costarc/MSX_IDC_ADAPTER/Hardware Interface/MSX_FPGA_Hat.pdf

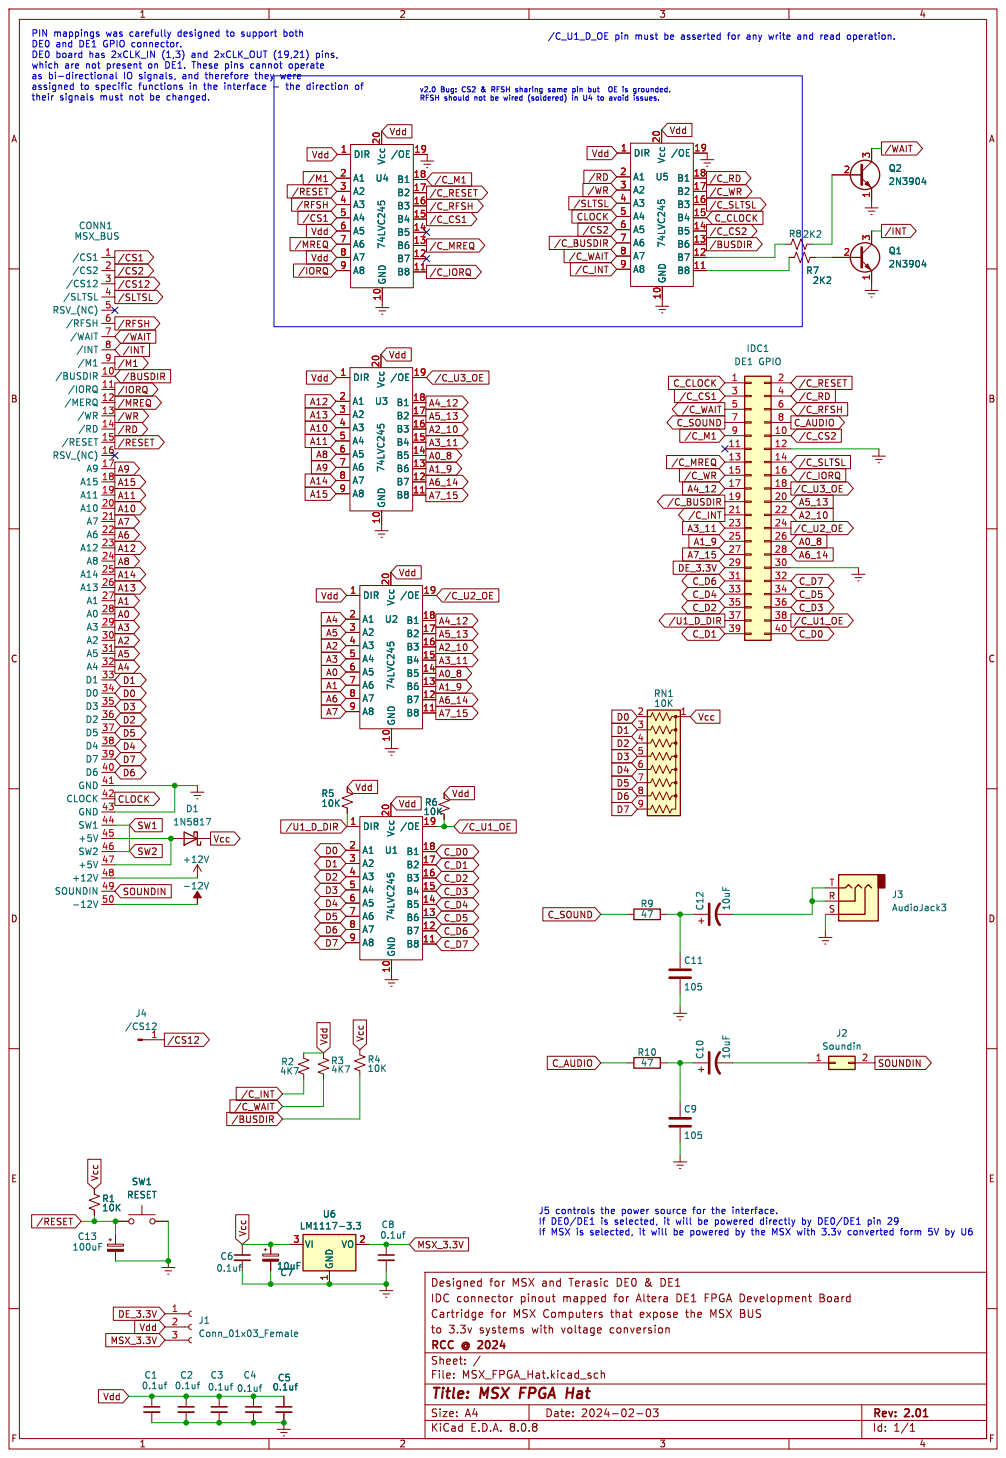
[picture p1: page 1]
