costarc/MSX_IDC_ADAPTER/Hardware Interface/MSX_FPGA_Hat.kicad_pcb

## KiCad design Hardware Interface/MSX_FPGA_Hat.kicad_pcb (2025-01-13)

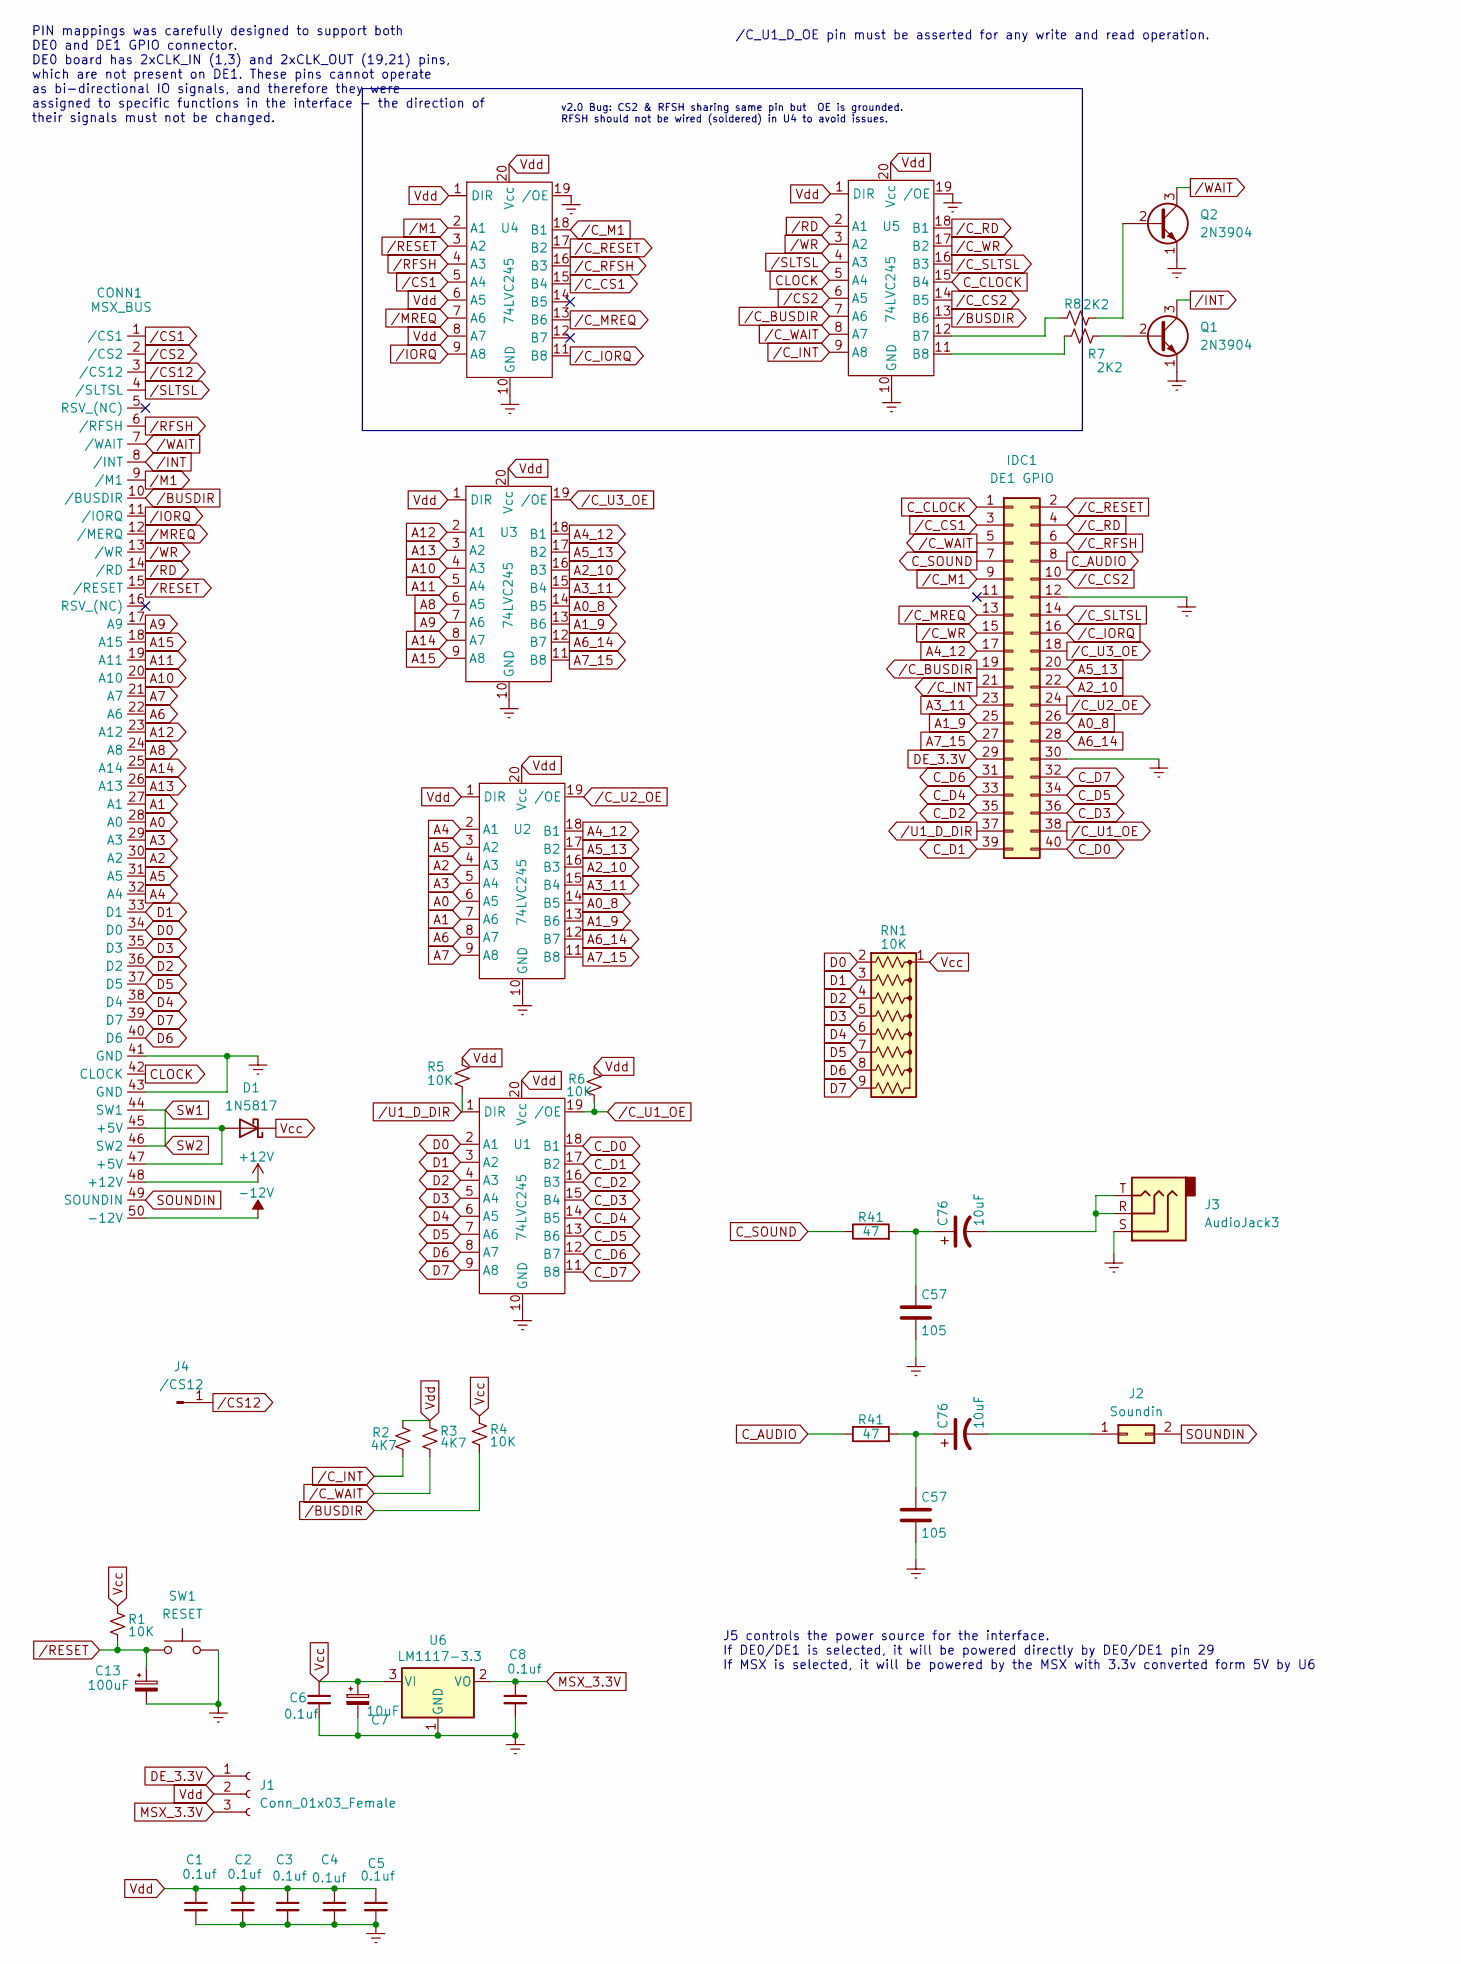
[picture p2: schematic MSX_FPGA_Hat.kicad_sch, MSX FPGA Hat]

Parts:
C1, C2, C3, C4, C5, C6, C8: 0.1uf; C_Disc_D3.0mm_W1.6mm_P2.50mm
C7, C76: 10uF; CP_Radial_D5.0mm_P2.00mm
C13: 100uF; CP_Radial_D5.0mm_P2.00mm
C57: 105; C_Disc_D5.0mm_W2.5mm_P2.50mm
CONN1: MSX_BUS; MSX_CART_SW_Official
D1: 1N5817; D_DO-41_SOD81_P10.16mm_Horizontal
IDC1: DE1 GPIO; PinHeader_2x20_P2.54mm_Vertical
J1: Conn_01x03_Female; PinHeader_1x03_P2.54mm_Vertical
J2: Soundin; PinHeader_2x01_P2.54mm_Vertical
J3: AudioJack3; Jack_3.5mm_CUI_SJ1-3533NG_Horizontal
J4: /CS12; PinHeader_1x01_P2.54mm_Vertical
Q1, Q2: 2N3904; TO-92_Inline
R1, R4, R5, R6: 10K; R_Axial_DIN0207_L6.3mm_D2.5mm_P10.16mm_Horizontal
R2, R3: 4K7; R_Axial_DIN0207_L6.3mm_D2.5mm_P10.16mm_Horizontal
R7, R8: 2K2; R_Axial_DIN0207_L6.3mm_D2.5mm_P10.16mm_Horizontal
R41: 47; R_Axial_DIN0207_L6.3mm_D2.5mm_P10.16mm_Horizontal
RN1: 10K; R_Array_SIP9
SW1: RESET; SW_Tactile_SKHH_Angled
U1, U2, U3, U4, U5: 74LVC245; DIP-20_W7.62mm
U6: LM1117-3.3; SOT-223-3_TabPin2

Connections:
+12V: CONN1.48 (+12V)
-12V: CONN1.50 (-12V)
A0: CONN1.28 (A0), U2.6 (A5)
A0_8: IDC1.26, U2.14 (B5), U3.14 (B5)
A1: CONN1.27 (A1), U2.7 (A6)
A1_9: IDC1.25, U2.13 (B6), U3.13 (B6)
A2: CONN1.30 (A2), U2.4 (A3)
A2_10: IDC1.22, U2.16 (B3), U3.16 (B3)
A3: CONN1.29 (A3), U2.5 (A4)
A3_11: IDC1.23, U2.15 (B4), U3.15 (B4)
A4: CONN1.32 (A4), U2.2 (A1)
A4_12: IDC1.17, U2.18 (B1), U3.18 (B1)
A5: CONN1.31 (A5), U2.3 (A2)
A5_13: IDC1.20, U2.17 (B2), U3.17 (B2)
A6: CONN1.22 (A6), U2.8 (A7)
A6_14: IDC1.28, U2.12 (B7), U3.12 (B7)
A7: CONN1.21 (A7), U2.9 (A8)
A7_15: IDC1.27, U2.11 (B8), U3.11 (B8)
A8: CONN1.24 (A8), U3.6 (A5)
A9: CONN1.17 (A9), U3.7 (A6)
A10: CONN1.20 (A10), U3.4 (A3)
A11: CONN1.19 (A11), U3.5 (A4)
A12: CONN1.23 (A12), U3.2 (A1)
A13: CONN1.26 (A13), U3.3 (A2)
A14: CONN1.25 (A14), U3.8 (A7)
A15: CONN1.18 (A15), U3.9 (A8)
CLOCK: CONN1.42 (CLOCK), U5.5 (A4)
C_AUDIO: IDC1.8; also elsewhere on the board
C_CLOCK: IDC1.1, U5.15 (B4)
C_D0: IDC1.40, U1.18 (B1)
C_D1: IDC1.39, U1.17 (B2)
C_D2: IDC1.35, U1.16 (B3)
C_D3: IDC1.36, U1.15 (B4)
C_D4: IDC1.33, U1.14 (B5)
C_D5: IDC1.34, U1.13 (B6)
C_D6: IDC1.31, U1.12 (B7)
C_D7: IDC1.32, U1.11 (B8)
C_SOUND: IDC1.7; also elsewhere on the board
D0: CONN1.34 (D0), RN1.2 (R1), U1.2 (A1)
D1: CONN1.33 (D1), RN1.3 (R2), U1.3 (A2)
D2: CONN1.36 (D2), RN1.4 (R3), U1.4 (A3)
D3: CONN1.35 (D3), RN1.5 (R4), U1.5 (A4)
D4: CONN1.38 (D4), RN1.6 (R5), U1.6 (A5)
D5: CONN1.37 (D5), RN1.7 (R6), U1.7 (A6)
D6: CONN1.40 (D6), RN1.8 (R7), U1.8 (A7)
D7: CONN1.39 (D7), RN1.9 (R8), U1.9 (A8)
DE_3.3V: IDC1.29, J1.1
GNDREF: C1.2, C2.2, C3.2, C4.2, C5.2, C6.2, C7.2, C8.2, C13.2, CONN1.41 (GND), CONN1.43 (GND), IDC1.12, IDC1.30, J3.S, Q1.1 (E), Q2.1 (E), SW1.2, U1.10 (GND), U2.10 (GND), U3.10 (GND), U4.10 (GND), U4.19 (/OE), U5.10 (GND), U5.19 (/OE), U6.1 (GND); also elsewhere on the board
MSX_3.3V: C8.1, J1.3, U6.2 (VO)
unnamed 51: J3.R, J3.T; also elsewhere on the board
unnamed: CONN1.45 (+5V), CONN1.47 (+5V), D1.2 (A)
unnamed 53: J2.1; also elsewhere on the board
unnamed: Q1.2 (B), R7.1
unnamed: Q2.2 (B), R8.1
unnamed: R8.2, U5.12 (B7)
unnamed: R7.2, U5.11 (B8)
SOUNDIN: CONN1.49 (SOUNDIN), J2.2
SW1: CONN1.44 (SW1), CONN1.46 (SW2)
Vcc: C6.1, C7.1, D1.1 (K), R1.1, R4.1, RN1.1 (common), U6.3 (VI)
Vdd: C1.1, C2.1, C3.1, C4.1, C5.1, J1.2, R2.1, R3.1, R5.1, R6.1, U1.20 (Vcc), U2.1 (DIR), U2.20 (Vcc), U3.1 (DIR), U3.20 (Vcc), U4.1 (DIR), U4.6 (A5), U4.8 (A7), U4.20 (Vcc), U5.1 (DIR), U5.20 (Vcc)
/BUSDIR: CONN1.10 (/BUSDIR), R4.2, U5.13 (B6)
/CS1: CONN1.1 (/CS1), U4.5 (A4)
/CS2: CONN1.2 (/CS2), U5.6 (A5)
/CS12: CONN1.3 (/CS12), J4.1
/C_BUSDIR: IDC1.19, U5.7 (A6)
/C_CS1: IDC1.3, U4.15 (B4)
/C_CS2: IDC1.10, U5.14 (B5)
/C_INT: IDC1.21, R2.2, U5.9 (A8)
/C_IORQ: IDC1.16, U4.11 (B8)
/C_M1: IDC1.9, U4.18 (B1)
/C_MREQ: IDC1.13, U4.13 (B6)
/C_RD: IDC1.4, U5.18 (B1)
/C_RESET: IDC1.2, U4.17 (B2)
/C_RFSH: IDC1.6, U4.16 (B3)
/C_SLTSL: IDC1.14, U5.16 (B3)
/C_U1_OE: IDC1.38, R6.2, U1.19 (/OE)
/C_U2_OE: IDC1.24, U2.19 (/OE)
/C_U3_OE: IDC1.18, U3.19 (/OE)
/C_WAIT: IDC1.5, R3.2, U5.8 (A7)
/C_WR: IDC1.15, U5.17 (B2)
/INT: CONN1.8 (/INT), Q1.3 (C)
/IORQ: CONN1.11 (/IORQ), U4.9 (A8)
/M1: CONN1.9 (/M1), U4.2 (A1)
/MREQ: CONN1.12 (/MERQ), U4.7 (A6)
/RD: CONN1.14 (/RD), U5.2 (A1)
/RESET: C13.1, CONN1.15 (/RESET), R1.2, SW1.1, U4.3 (A2)
/RFSH: CONN1.6 (/RFSH), U4.4 (A3)
/SLTSL: CONN1.4 (/SLTSL), U5.4 (A3)
/U1_D_DIR: IDC1.37, R5.2, U1.1 (DIR)
/WAIT: CONN1.7 (/WAIT), Q2.3 (C)
/WR: CONN1.13 (/WR), U5.3 (A2)

Notes on the sheet:
PIN mappings was carefully designed to support both DE0 and DE1 GPIO connector. DE0 board has 2xCLK_IN (1,3) and 2xCLK_OUT (19,21) pins, which are not present on DE1. These pins cannot operate as bi-directional IO signals, and therefore they were assigned to specific functions in the interface - th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
/C_U1_D_OE pin must be asserted for any write and read operation.
J5 controls the power source for the interface. If DE0/DE1 is selected, it will be powered directly by DE0/DE1 pin 29 If MSX is selected, it will be powered by the MSX with 3.3v converted form 5V by U6
v2.0 Bug: CS2 & RFSH sharing same pin but OE is grounded. RFSH should not be wired (soldered) in U4 to avoid issues.

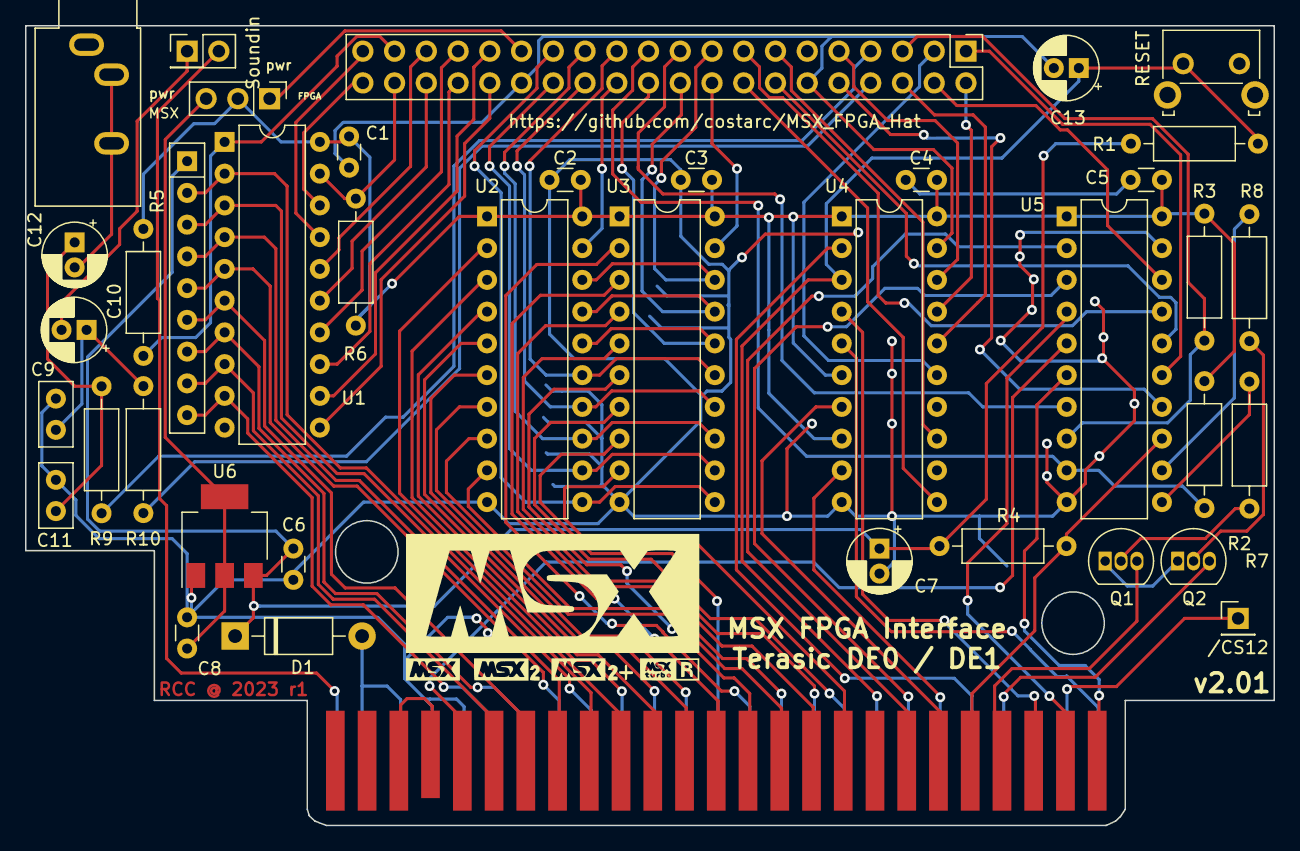
[picture p3: board MSX_FPGA_Hat.kicad_pcb from above]

Board: 2 copper layers, 99.9 x 64.0 mm, 40 parts (0 on the bottom side), 91 nets.

Other parts of the board:
C9, C11: 105; C_Disc_D5.0mm_W2.5mm_P2.50mm
C10, C12: 10uF; CP_Radial_D5.0mm_P2.00mm
R9, R10: 47; R_Axial_DIN0207_L6.3mm_D2.5mm_P10.16mm_Horizontal

Their connections:
C_AUDIO: R10.1; also elsewhere on the board
C_SOUND: R9.1; also elsewhere on the board
GNDREF: C9.2, C11.2; also elsewhere on the board
unnamed: C9.1, C10.1, R10.2
unnamed: C11.1, C12.1, R9.2
unnamed 51: C12.2; also elsewhere on the board
unnamed 53: C10.2; also elsewhere on the board
