costarc/MSX_IDC_ADAPTER/(commit log)

2025-01-13 fixed typos in the schematic info text
    [MSX_FPGA_Hat.kicad_pcb, MSX_FPGA_Hat.kicad_sch]
2025-01-13 updated pdf with 2.01 schematic
